ingihel/betaspray/notebooks/max/README.md

# Max's Lab Notebook — ECE 445, Team 41: BetaSpray

---

## Project Proposal Summary

**Project:** BetaSpray — Climbing Route Visualization System  
**Team 41:** Maxwell Beach (mlbeach2), Prakhar Gupta, Ingi Helgason  
**Course:** ECE 445, Spring 2026

BetaSpray is a standalone device that mounts above a climbing spray wall, captures a 5 MP image of the wall, detects individual holds via computer vision, and uses four servo-actuated laser pointers to illuminate any user-defined route in real time. The device eliminates the need for verbal route descriptions, paper notes, or hold markings, and is designed to cost less than $100 — less than 10% of the cheapest comparable commercial offering (MoonBoard: ~$3,705; Kilter Board: ~$7,649+).

### High-Level Requirements

| # | Requirement | Metric |
|---|---|---|
| HLR-1 | **Accurate Projection** | Laser pointing error ≤ 5 cm at 3 m projection distance |
| HLR-2 | **Vision Detection** | ≥ 90% of holds detected in ≤ 30 s under ≥ 300 lux gym lighting |
| HLR-3 | **Responsive Interface** | ≤ 200 ms between app request and visible laser point |
| HLR-4 | **Eye Safety** | All lasers Class 2 (< 1 mW visible, IEC 60825-1 compliant) |

### Block Diagram

> **Fig. 1** : System block diagram. Shows four subsystems — Power, Vision, Projection, and UI — and their interconnections. *See attached image  of `graphviz (1).png`.*

### Component Selection

| Component | Part | Justification |
|---|---|---|
| MCU | ESP32-S3 N16R8 (16 MB flash, 8 MB PSRAM) | Wi-Fi soft-AP, 8 LEDC channels, 8 MB PSRAM for camera frame buffers |
| Camera | OV5640 5 MP (DVP parallel bus) | 5 MP for fine hold discrimination; DVP supported by ESP-IDF camera driver [Ref. 1] |
| Servos | SG90 × 8 (4 gimbals, pan + tilt) | Low cost, 180° travel; accuracy limitations addressed via calibration (see Eq. 4, Eq. 5) |
| Lasers | Class 2 diodes × 4 | < 1 mW, IEC 60825-1 compliant [Ref. 4] |
| LDO | LM3940IT-3.3 | True LDO, supports down to 4.5 V input, TO-220 package |
| Connector | USB-C 5 V power + data | Standard supply; no USB data used — power only |

> **Fig. 2** : Completed BetaSpray device. *See attached image of `IMG_7198.jpg`.*

---

## Bibliographic References

**[Ref. 1]** Espressif Systems. *ESP-IDF Programming Guide: LEDC (LED Control) Peripheral.* https://docs.espressif.com/projects/esp-idf/en/stable/esp32s3/api-reference/peripherals/ledc.html

**[Ref. 2]** Tower Pro. *SG90 Micro Servo Datasheet.* Tower Pro Co., Ltd. http://www.towerpro.com.tw/product/sg90-7/

**[Ref. 3]** OmniVision Technologies. *OV5640 Camera Module (DVP Interface) Software Application Notes.* Rev 1.02. OmniVision Technologies, Inc.

**[Ref. 4]** International Electrotechnical Commission. *IEC 60825-1: Safety of Laser Products — Part 1: Equipment Classification and Requirements.* Edition 3.0, 2014.

**[Ref. 5]** ChaN. *FatFs — Generic FAT Filesystem Module.* http://elm-chan.org/fsw/ff/

**[Ref. 6]** OpenCV. *cv2.watershed: Marker-based Watershed Algorithm.* https://docs.opencv.org/4.x/d7/d1b/group__imgproc__misc.html

**[Ref. 7]** Bradski, G. "The OpenCV Library." *Dr. Dobb's Journal of Software Tools* (2000).

---

## Feb 24, 2026

**PCB — Servo control schematic**

Started laying out the servo control subsystem in KiCad. Added servo control schematic and created a dedicated `servo_subsystem` sheet, separating it from the main schematic for clarity. Also added custom connector symbols to `betaspray_Connector.kicad_sym`.

**Design problem:** The initial schematic placed all servo headers on a single sheet alongside the MCU and power circuitry, making the schematic unreadable and DRC-difficult. Decision: split into a hierarchical sub-sheet (`servo_subsystem`) so each subsystem's nets can be reviewed independently. Custom connector symbols added because the KiCad standard library did not include a single-row 3-pin servo header with the correct PWM/VCC/GND pin order for SG90.

Commits: `353742f` (add servo control), `2e1eb66` (add servo_subsystem)

---

## Feb 26, 2026

**PCB — Added routing tracks**

Added routing tracks to the PCB layout connecting servo headers to GPIO net labels. At this stage the board is 4-layer; routing decision was to place power planes on layers 2 and 3, signal on layers 1 and 4.

**Design problem:** The servo supply current at full load (8 × SG90 stall at ~180 mA each = 1.44 A peak) required wider traces than the default 0.25 mm DRC rule. Set servo power traces to 1 mm to keep I²R drop below 50 mV. Signal (PWM) traces remain 0.25 mm.

Commits: `061b5df`

---

## Mar 2, 2026

**PCB — Schematic revisions and bulk capacitors for servos**

Updated power and servo subsystem schematics. Added bulk decoupling capacitors on the servo supply rails.

**Design decision:** Without bulk capacitance on the servo rail, simultaneous servo activation during leapfrog sequencing causes a voltage droop that resets the ESP32-S3. The LM3940IT-3.3 datasheet [Ref. 3 — verified against LM3940 datasheet] specifies 10 µF minimum at output; we added 100 µF electrolytic + 100 nF ceramic per rail for margin. Two 100 µF caps placed close to servo headers (one per bank of 4 servos).

**Proposed test:** Scope 5 V rail while triggering all 8 servos simultaneously; verify droop < 250 mV pk-pk. Verify 3.3 V rail stable under same transient.

Worked on full PCB layout revision (Ver0) and submitted Gerbers for review.

Commits: `89470c7` (added bulk CAP servos), `fc46deb` (Ver0, pls')

---

## Mar 3, 2026

**Firmware — FatFS integration**

Merged in FatFS support [Ref. 5]: added `fatfs.c/h` and `fatfs.md`, updated `platformio.ini`, and wired `fatfs_init()` into `main.c`. This enables wear-levelled FAT on internal flash mounted at `/fatfs`, used for route file storage (up to 50 routes).

**Design problem:** The default ESP-IDF NVS key-value store has a maximum value size of ~4 KB and does not support file-like sequential reads. Route files (JSON arrays of pixel coordinates) can be larger and need to survive reboots. FatFS on a dedicated flash partition solves both constraints without adding external storage hardware.

Commit: `f3b38aa`

---

## Mar 4, 2026

**Camera — Lens distortion documentation**

Added `src/Camera_Distortion.md` documenting the OV5640 lens distortion model, the calibration approach, and how the distortion coefficients are used. Kevin helped with this. The OV5640 uses a fixed wide-angle lens with measurable barrel distortion; uncorrected, straight lines near the frame edge bow inward by several pixels, degrading hold centroid accuracy.

Commit: `76ab29b`

---

## Mar 5, 2026

**Camera — Calibration tooling and `conf.h` intrinsics**

Added `calibrate_camera.py` (checkerboard-based intrinsic calibration using OpenCV [Ref. 7]), `partitions.csv` (custom partition table), and camera intrinsic constants in `conf.h`. The calibration script prints `fx`, `fy`, `cx`, `cy`, and the distortion vector `[k1, k2, p1, p2, k3]` as C-compatible constants.

**Constraint noted:** PSRAM is needed for fast/reliable calibration — the dev board DRAM (~512 KB available) is too limited for reliable multi-frame capture at the resolutions needed for checkerboard detection. Calibration deferred until PSRAM-equipped hardware is available (either final PCB or N16R8 module).

Also expanded `Camera_Distortion.md` with calibration procedure details.

Commit: `89bbbd2`

---

## Mar 5, 2026

**Firmware — GPIO conflict fix for servo 0**

**Problem:** The originally assigned GPIO for servo 0 (`SERVO_PIN_0 = 4`) conflicted with camera pins on the ESP32-S3. The OV5640 DVP interface uses GPIO4 as `HREF`; driving PWM on the same pin when the camera peripheral is active caused the camera to lose frame sync.

**Diagnosis:** Reviewed the ESP32-S3 datasheet GPIO matrix table. GPIO4 is shared between the LEDC PWM peripheral and the DVP camera `HREF` signal. The camera driver locks the pin via the I/O mux, so any subsequent LEDC configuration silently fails or contends.

**Fix:** Moved `SERVO_PIN_0` to GPIO1 (ADC1_CH0) and `SERVO_PIN_1` to GPIO2, which have no camera, JTAG, USB, PSRAM, or strapping pin conflicts. Updated `agent.md` with corrected pin map.

**Corrected GPIO assignments (as of this commit):**

| Servo | GPIO | Notes |
|---|---|---|
| 0 (Gimbal 0, X) | 1 | ADC1_0, no conflicts |
| 1 (Gimbal 0, Y) | 5 | ADC1_4, TOUCH5 |
| 2 (Gimbal 1, X) | 6 | ADC1_5, TOUCH6 |
| 3 (Gimbal 1, Y) | 7 | ADC1_6, TOUCH7 |
| 4 (Gimbal 2, X) | 8 | ADC1_7, TOUCH8 |
| 5 (Gimbal 2, Y) | 9 | FSPI_HD, free since FSPI unused |
| 6 (Gimbal 3, X) | 10 | FSPI_CS0, free since FSPI unused |
| 7 (Gimbal 3, Y) | 11 | FSPI_D, free since FSPI unused |

Commit: `133a38b`

---

## Mar 5, 2026

**Firmware — SG90 PWM parameters and servo driver working on GPIO1, GPIO2**

Established correct PWM parameters for SG90 servos and got the servo driver working on the corrected pins.

**SG90 PWM specification [Ref. 2]:**
- Control signal period: 20 ms (50 Hz)
- Pulse width: 0.5 ms (0°) to 2.4 ms (180°)

**Eq. 1 — Duty count vs. angle (14-bit LEDC timer, 50 Hz):**

```
duty_count = DUTY_MIN + (angle / 180) × (DUTY_MAX - DUTY_MIN)

where:
  DUTY_MIN = round(16384 × 0.5 ms / 20 ms)  = 410 counts   (0°)
  DUTY_MAX = round(16384 × 2.4 ms / 20 ms)  = 1966 counts  (180°)
  Resolution: (1966 − 410) / 180 ≈ 8.6 counts/degree
```

Note: the initial firmware used DUTY_MIN=819, DUTY_MAX=1638 (1–2 ms range, per a commonly cited SG90 note). Testing showed the SG90 requires the extended 0.5–2.4 ms range for full 180° travel; the 1–2 ms range only produces ~90° of motion. Updated to extended range in this commit. At 3.3 V supply the servo may buzz at the extremes — back off DUTY_MIN/MAX slightly if binding occurs.

**Hardware fade + hold logic:** Added `ledc_set_fade_with_time()` to smooth servo movement and reduce mechanical shock. Fade duration set to `SERVO_DURATION_MS` (currently 300 ms) so the servo steps smoothly rather than snapping. The LEDC fade ISR is installed once at `servo_init()`; subsequent calls handle the `ESP_ERR_INVALID_STATE` return gracefully.

Added servo test functions; wired servo testbench calls into `main.c` startup sequence. Verified servo 0 (GPIO1) and servo 1 (GPIO2) sweep 0°–180° cleanly.

**Test result:** Both servos sweep full range. No camera interference observed. Servo supply showed ~80 mV droop on 5 V rail during simultaneous movement — within the 250 mV spec.

PCB Gerbers generated. 2-layer board revision submitted for fabrication (cost driver: 2-layer significantly cheaper than 4-layer for this board size).

Commits: `bfce7ad` (Servo test functions working for pins 1,2), `e904c0f` (2 layer PCB submitted)

---

## Mar 7, 2026 *(team context — Ingi's notebook)*

**CV — Difference of Gaussian blob detector ready**

Ingi completed a DoG-based blob detector (`differenceofgaussian.c`) for climbing hold detection. Runs on host (gcc, libjpeg), designed to be portable to ESP32-S3 later. Algorithm: multi-octave Gaussian pyramid, DoG layers, extremum detection, non-maximum suppression. Ingi also extended `client.py` to support an image viewer and sending detected blob coordinates directly as a route file to the ESP32.

**Noted constraint:** The dev board (no PSRAM) cannot run this on-device — the DoG scale buffers at 320×240 require more SRAM than is available. The custom PCB (N16R8, 8 MB PSRAM) will unblock on-device CV testing.

---

## Mar 7–8, 2026 *(team activity — Ingi and Prakhar)*

**CV and HTTP camera bring-up on dev board**

Ingi: DoG blob detector (`differenceofgaussian.c`) completed and tuned. HTTP camera wrapper (`GET /capture`) working; first live JPEG captured over WiFi from dev board. `client.py` extended with image viewer and blob-coordinate-to-route-file flow.

Prakhar: `client.py` route XY→angular conversion added, FOV/2 clamping on angle output. HTTP camera endpoint reworked to use a static frame buffer instead of dynamic allocation (fixes intermittent malloc failure under load).

---

## Mar 23–25, 2026 *(PCB — Prakhar)*

**PCB Rev 2 — footprint fix**

Ver0 PCB returned from fab. The DVP camera header footprint did not match the physical connector — pitch mismatch. Root cause: footprint pulled from a third-party KiCad library and not cross-checked against the physical connector datasheet. KiCad DRC passed because the footprint was internally consistent; the error was at the symbol-to-part level, not in routing. Prakhar corrected the footprint and ordered PCB Rev 2 (commits `cca24e09`, `e6dbf904`).

---

## Apr 1, 2026

**Camera — Tiled high-res capture for low-memory dev board**

The N8 dev board has no PSRAM, so a full UXGA (1600×1200) frame cannot be captured in one shot (would require ~5.8 MB DMA buffer; only ~512 KB DRAM available). Implemented a tiling approach using the OV5640 crop window registers.

**Approach:** The OV5640 sensor crop window is set via timing registers (0x3800–0x3807) to capture a QVGA-sized tile at 1:1 native pixels from a different region of the full 2592×1944 active array. The ISP scales the crop to the fixed QVGA DMA buffer, keeping DMA timing unchanged across tiles.

**Eq. 2 — Tile pixel-to-full-image coordinate mapping:**

```
full_x = col × (2592 / TILE_COLS) + tile_x
full_y = row × (1944 / TILE_ROWS) + tile_y
```

Default grid: 8×8 tiles → stitched output 2560×1920 pixels (2592/8 = 324 px/tile, rounded to QVGA=320).

New `/capture/tile` endpoint accepts `{"col": N, "row": N}` and returns tile JPEG with `X-Tile-Grid` and `X-Tile-Pos` response headers. Added `camera_set_window()` / `camera_reset_window()` to `camera.c/h`. Updated `client.py` with `capture_tile()` / `capture_tiled()` and `capture-tiled` CLI subcommand (Pillow-based stitching on host).

**Key constraint:** AE/AWB re-converges per tile, producing inconsistent exposure across the stitched image. Fix: lock AE before the first tile capture. Subsampling/binning registers intentionally not touched at runtime to avoid losing DMA sync.

**Result:** Tiling approach produces a stitched image but inter-frame motion and stitching seams broke hold detection. This approach was abandoned in favor of running CV host-side on a single full-resolution capture once PSRAM was available (see Apr 14).

Commit: `2a6c89f`

---

## Apr 2, 2026

**Camera/Client — Tiled capture debugging; stitching still broken**

Continued debugging the tiled capture approach. Reduced tile grid from 8×8 to 4×4 (`--cols 4 --rows 4`) to see if fewer tiles reduces inter-frame motion artifacts. Added error handling to `client.py` `capture_tile()`: if the ESP returns a non-JPEG content-type (e.g. `"Camera disabled"` plain-text error), raise a `RuntimeError` immediately rather than trying to decode corrupt bytes. Also updated `conf.h` and `camera.c` with revised tile grid constants and camera config experiments.

**Difficulty:** Even at 4×4 tiles, the hold detector fails on the stitched result — AE/AWB re-convergence per tile creates visible seam lines that the Gaussian background subtraction interprets as large blobs. Conclusion: tiled stitching on the dev board is not a viable path to full-res hold detection. Must wait for the PCB (PSRAM) to capture a full-res frame in one shot.

Commit: `5000394` ("this ain't workin chief")

---

## Apr 6, 2026

**System integration — PCB Rev 2 bring-up; camera + servo running simultaneously**

First integration session with PCB Rev 2. Objective: get camera and servos running together on the N16R8 module.

**Problem 1 — Camera VSYNC/HREF pin swap (hardware bug):**
Camera was producing garbage frames. Diagnosed by comparing the `camera.h` pin definitions against the OV5640 connector pinout on Rev 2. Pins `CAM_PIN_VSYNC` and `CAM_PIN_HREF` were swapped: firmware had VSYNC→GPIO47 and HREF→GPIO2, but on the physical connector they are reversed. Corrected: VSYNC→GPIO2, HREF→GPIO47.

**Problem 2 — Servo init was commented out in `main.c`:**
`servo_init()` was commented out from the prior dev-board configuration (GPIO conflicts with camera on that board). Re-enabled now that PCB Rev 2 uses correct non-conflicting GPIO assignments (GPIO1, 5–11).

**Problem 3 — Frame buffer allocation failing after WiFi stack init:**
Initial config used `CAMERA_FB_IN_DRAM`. After WiFi stack comes up, DRAM heap is too fragmented for the double frame buffer. Fix: switch frame buffer location to `CAMERA_FB_IN_PSRAM` — the N16R8's 8 MB PSRAM has sufficient contiguous space. Confirmed via smoketest.

**Problem 4 — OV5640 DVP signal integrity at 25 MHz:**
Random DMA desync errors visible as corrupt JPEG rows. Cause: ribbon cable between camera module and PCB is too long for 25 MHz PCLK without impedance control. Fix: slowed PCLK via OV5640 register writes [Ref. 3]:

```
s->set_reg(s, 0x460C, 0xFF, 0x35);  // enable manual PCLK period mode
s->set_reg(s, 0x3824, 0xFF, 0x01);  // PCLK divider = 4
```

This halves the effective pixel clock rate, reducing signal integrity requirements on the cable. JPEG corruption eliminated after this change. Noted for future PCB revision: length-match DVP data lines or use a shorter cable.

**Smoketest added (`smoketest.c`):**
Wrote `smoketest_run()` to run at boot and verify: (a) PSRAM ≥ 7.5 MB free (N16R8 expected 8 MB, allows 512 KB for system reservations), (b) heap integrity. Logs pass/fail per check at INFO level. Useful for catching memory regressions introduced by config changes.

**OV5640 startup stabilization:**
Added discard of first 3 frames at init — OV5640 outputs garbage frames for ~200–300 ms while the sensor PLL and AE/AWB converge. Three 100 ms discards reliably clear this.

**Servo driver simplification:**
Removed the "restore duty before fade" workaround from `servo_drive()`. The workaround had been added to fix a fade-start-from-zero issue but was causing servo jitter on the first move. Root cause was that the LEDC duty register was being set to 0 after each move (power-saving holdover from dev board). Changed: servo now holds at target angle after each drive command (`servo_current_angle[id]` preserved; duty not zeroed). This also eliminates the re-initialization delay.

**Test result:** Camera and servos working simultaneously on PCB Rev 2. System serving HTTP over WiFi, capturing JPEG, and driving servos in response to `/route/play` commands.

Commits: `3ab7395` (pin + camera config fixes), `42968dd` (smoketest, servo simplification), `64128b0` (smoketest working), `cc63092` (PSRAM for camera FB), `288c4c3` (PCLK divider, route refactor)

---

## Apr 14, 2026

**Camera — JPEG quality floor established**

Through on-device testing, determined that the minimum viable JPEG quality setting on the OV5640 is **3** (firmware 0–63 scale, where 0 = best quality). Values below 3 produce block artifacts severe enough to break the hold detection pipeline.

**Constraint:** At 5 MP (2592×1944), a decoded RGB888 frame is 2592×1944×3 = **15.1 MB**, which exceeds the 8 MB PSRAM ceiling. On-device image processing at full resolution is not feasible. Decision: all CV runs host-side. ESP32 streams JPEG over HTTP; host Flask app decodes and runs pipeline.

**CV — Ported ImageJ hold detector to Python/OpenCV (`client.py`)**

Ported `Betaspray-hold-extractor.ijm` to a native Python/OpenCV pipeline (`detect_holds()` in `client.py`) [Ref. 6, Ref. 7]. Pipeline steps:

1. Median blur (despeckle)
2. Gaussian background subtraction (approximates ImageJ rolling ball radius=100)
3. CLAHE (contrast-limited adaptive histogram equalization)
4. Second median + despeckle
5. HSV threshold (V ≤ 183) — isolates holds from background
6. Fill holes (binary morphology)
7. Morphological open (remove noise)
8. Connected components, filter by area ≥ 150 px

Outputs list of hold centroids and annotated image.

Added `select_holds_interactive()`: matplotlib window showing detected holds overlaid on the captured image. Clicking toggles hold selection (red → green); closing the window sends the selected hold list to the ESP32 via `POST /route/create`.

**App — Wired CV pipeline into `app.py` web UI**

Modified `app.py` to replace the DoG binary subprocess in `/detect` with a direct call to `detect_holds()` imported from `client.py`. "New Route (detect holds)" in the web UI now runs the full OpenCV pipeline server-side.

> **Fig. 5** (left-hand page): Vision pipeline sample output on test wall image. Annotated hold centroids shown in green overlaid on original image (5 m distance). *See attached image of `image_annotated.png`.*

Commits: `ac1fb4f`, `404f85c`, `32907e7`

---

## Apr 19, 2026

**App — Upload image feature**

Added "Upload Image" button to `app.py` web UI (hidden `<input type="file">`, JPEG/PNG accepted) so wall images can be loaded without a live camera.

**CV — Fixed hold detection pipeline — two bugs causing only 1 centroid returned**

**Bug 1 — Background subtraction algebra error:**
The first implementation of the rolling-ball subtraction simplified algebraically to just `GaussianBlur(working)`, not true background removal.

*Incorrect:* `result = clip(working - GaussianBlur(working), 0, 255)`

*Correct (mirrors ImageJ "light background"):*
```
inv        = 255 - working
result_inv = clip(inv - GaussianBlur(inv), 0, 255)
result     = 255 - result_inv
```
The sign error meant the step was suppressing foreground signal (holds) rather than background.

**Bug 2 — Missing watershed step:**
The port omitted `run("Watershed")` from the IJM (line 67). Without watershed, touching hold blobs merge into one connected component and produce a single centroid near the image center.

Fix: Added OpenCV distance-transform watershed after the morphological open [Ref. 6]:
1. Compute Euclidean distance transform of binary mask
2. Find local maxima of distance transform → seeded markers
3. Run `cv2.watershed()` to split touching blobs

**Result after fixes:** Detection on `test.jpg` (2560×1709) returns 200+ hold candidates spread across the full image, matching the IJM reference output.

---

## Apr 20, 2026

**Firmware — Leapfrog route playback mode**

Redesigned route playback from sequential (all gimbals move hold-by-hold together) to leapfrog, where each gimbal advances independently through the hold list, keeping N gimbals always pointing at N adjacent holds simultaneously. The wall is never dark while servos are moving.

**Design decisions:**
- `drive_gimbal(g, hold_idx, total, hold)` encapsulates pixel→angle, correction, and both servo drives for one gimbal assignment. A 100 ms delay between X and Y servo commands lets the first servo's inrush current settle before the second starts (reduces peak draw on shared supply).
- `s_leap_hold[NUM_SERVOS/2]` tracks each gimbal's current hold index independently; `s_leap_next` round-robins which gimbal advances on each `/route/next` trigger.
- At route start, gimbals are staggered 300 ms apart during initialization to prevent simultaneous inrush current from drooping the 5 V rail. Verified: staggered init keeps rail droop < 250 mV.
- Both manual (wait for `/route/next`) and timed (interval_ms in play request) advance modes supported.

Servo direction and axis corrections also made this session — X/Y mappings in `route.c` were inverted for some gimbals.

Commits: `e394266` (leapfrog), `614a61a` (servo directions)

---

## Apr 23, 2026

**Firmware/App — Gimbal calibration system and safe zero ordering**

Added full per-gimbal pointing calibration workflow.

**Firmware (`server.c`, `route.c`):**
- `POST /gimbal/zero` zeros all gimbals in a mechanically safe sequence to prevent physical clashes on return. Sequence: gimbal 1 (back-left) first, then gimbal 0 (front-right), then gimbal 2 (back-right). Each step has a 300 ms delay. This mirrors the inward-before-outward retract pattern; testing confirmed zero clashing with this order.
- `POST /gimbal/offset` stores per-gimbal signed degree correction `(dx, dy)` and applies it during playback via `s_gimbal_offset_x[g]` / `s_gimbal_offset_y[g]`.

**App (`app.py`):**
- New gimbal calibration panel: "Enter Cal Mode" zeros gimbals, then clicking anywhere on the canvas drives the selected gimbal to that pixel position.
- Arrow nudge buttons (1°/2°/5° steps) for fine-tuning.
- "Save Offset" persists correction to `gimbal_offsets.json`.
- `/gimcal/point` proxies to ESP `POST /gimbal/point`, ensuring the same geometric formula used at playback is also used during calibration data collection.

Commit: `f9d279a`

---

## Apr 25, 2026

**Firmware — Geometric pixel→angle projection formula**

Replaced the open-loop linear pixel→angle approximation with a proper geometric projection.

**Eq. 3 — Old linear formula (rejected):**
```
angle_x = (center_x - px) × (HFOV / width) + 90
```
This formula assumes the wall is at a uniform angular offset per pixel, which is only valid for small FOV. At 120° HFOV and high elevation angles the error is large (see Eq. 4).

**Eq. 4 — Servo pointing error at high elevation angle [Ref. 2]:**
```
Δx = (d / cos²θ) × Δθ_rad

At d = 3 m, θ = 53.1° (h = 4 m), SG90 rated error ±1° (Δθ = 0.0175 rad):
Δx = (3 / cos²(53.1°)) × 0.0175
   = (3 / 0.360) × 0.0175
   ≈ 14.6 cm  (>> 5 cm HLR-1 spec)
```
Wall position error scales as 1/cos²θ; the same 1° servo error blows up at high elevation angles. This is the fundamental reason open-loop SG90s cannot meet the 5 cm spec without calibration.

**Eq. 5 — New geometric projection (adopted):**
```
Step 1: Scale intrinsics to current image resolution
  fx' = fx × (img_w / cal_w)
  fy' = fy × (img_h / cal_h)
  cx' = cx × (img_w / cal_w)
  cy' = cy × (img_h / cal_h)

Step 2: Project pixel onto wall plane at distance dist (meters)
  wall_x = (px - cx') / fx' × dist
  wall_z = (cy' - py) / fy' × dist

Step 3: Apply gimbal physical offset from camera origin (conf.h)
  dx = wall_x - gimbal_x
  dy = dist   - gimbal_y
  dz = wall_z - gimbal_z

Step 4: Compute servo angles
  servo_x = 90 - degrees(atan2(dx, dy))   (pan)
  servo_y = 90 + degrees(atan2(dz, dy))   (tilt)
```

Gimbal physical positions added to `conf.h` in right-hand coordinate frame (+X right, +Y toward wall, +Z up).

Commit: `03a6e8a` (Prakhar — geometric baseline), `418faee` (corrected offsets, Max)

---

## Apr 25, 2026

**Hardware — Measured and corrected gimbal physical positions**

Initial `conf.h` estimates were significantly off. After measuring the assembled enclosure with calipers:

| Gimbal group | conf.h estimate | Measured | Correction |
|---|---|---|---|
| Front gimbals — Y (depth behind camera) | 3.5 cm | **6 cm** | +71% |
| Front gimbals — Z (height above camera) | est. | 3.5 cm | — |
| Back gimbals — Y | 7 cm | **13 cm** | +86% |
| Back gimbals — Z | est. | **13 cm** | +86% |

Both back gimbal axes were roughly double the estimates. These values feed directly into the atan2 angle computation; accuracy scales with measurement precision.

**Additional findings this session:**
- Gimbal 0 (front-right, servos 0/1) suffered a mechanical failure and was taken out of service. `NUM_SERVOS` reduced from 8 to 6; `servo_pins[]` remapped to skip old pins 0/1. Leapfrog updated to 3 gimbals.
- Old servos 1 and 3 (Y-axis of the two front gimbals) are mounted 45° offset from the rear Y-axis servos — they sit mechanically flat at 45° PWM rather than 90°. Added `servo_offset[]` table in `servo.c` and a `physical_angle()` helper:

**Eq. 6 — Physical angle correction for offset-mounted servos:**
```
pwm_angle = commanded_angle + servo_offset[id]
```
where `servo_offset[id]` is 0° for most servos and −45° for the two front Y-axis servos (indexes 1, 3). Applied just before duty-cycle conversion, keeping the commanded-angle space consistent throughout the codebase.

Commit: `418faee` (changed offsets), `cf32e63` (calibration setup)

---

## Apr 25, 2026

**Firmware/App — Bilinear polynomial correction system**

A constant per-gimbal offset (dx, dy) can only correct a uniform pointing bias. It cannot handle errors that vary across the frame — parallax, residual lens distortion, or axis coupling (Y servo tilt slightly deflecting X axis). Added a bilinear polynomial correction layer on top of the geometric baseline.

**Eq. 7 — Bilinear polynomial correction model (8 coefficients per gimbal):**
```
corrected_x = raw_x + (a0 + a1·raw_x + a2·raw_y + a3·raw_x·raw_y)
corrected_y = raw_y + (b0 + b1·raw_x + b2·raw_y + b3·raw_x·raw_y)
```
- `a0/b0`: constant bias (subsumes the old per-gimbal offset)
- `a1/b1`: scale error along each axis
- `a2/b2`: cross-axis bleed (Y movement affects X, and vice versa)
- `a3/b3`: position-dependent (bilinear) coupling term

**Firmware:**
- `apply_poly_correction()` runs at playback for every hold
- Coefficients persist to FatFS (`/fatfs/gimbal_poly.bin`) and reload on boot
- `POST /gimbal/poly` sets coefficients; `GET /gimbal/poly` reads them back

**Host (least-squares fit):**
The design matrix for each calibration point `(raw_x, raw_y)` is `[1, raw_x, raw_y, raw_x·raw_y]`. The residual is `target_angle − actual_angle`. Coefficients solved via `numpy.linalg.lstsq`. Minimum 4 calibration points per gimbal required to determine all 4 coefficients.

**Calibration UX:** 9-point crosshair grid overlaid on canvas → click crosshair to drive gimbal + auto-capture fresh image → click where laser dot actually appears → point recorded → "Fit" once ≥4 points collected per gimbal.

Commit: `aadfa3e` (polyfit + laser — Prakhar), `cf32e63` (calibration setup — Max)

---

## Apr 28, 2026

**Firmware — Camera frame staleness fix**

**Problem:** With `fb_count=1` and `CAMERA_GRAB_WHEN_EMPTY` mode, `esp_camera_fb_get()` returns the already-queued frame — captured *before* the HTTP request arrived, i.e., before any recent servo movement or laser state change. A fresh capture required sending two consecutive request pairs.

**Root cause:** `esp_camera_fb_get()` returns immediately if a completed frame is already in the DMA buffer. There is no API to signal the DMA to start a new frame from a specific timestamp [Ref. 1].

**Fix in `camera_capture_frame()`:**
```c
// Discard stale queued frame, then block for the next genuinely new frame.
camera_fb_t *stale = esp_camera_fb_get();
if (stale) esp_camera_fb_return(stale);
camera_fb_t *fb = esp_camera_fb_get();  // blocks until post-request frame ready
```

One single `POST /capture` + `GET /get` now reliably returns the current frame. The 400 ms compensating sleep in the poly-cal capture flow was also removed.

**Test:** Triggered capture immediately after servo move command. Verified returned frame shows updated gimbal position (laser dot visible in new location). Confirmed across 10 trials — no stale frames returned.

Commit: `8d18d36`

---

## Apr 29, 2026

**Final Performance Verification**

All four high-level requirements verified on the demo wall.

### Projection Subsystem Test Results

> **Fig. 6** : Laser pointing error histogram across all 3 gimbals × 20 test points = 60 measurements. *See attached printout of `error_histogram.png`.*

> **Fig. 7** : Per-gimbal error scatter plot. X/Y error in cm at 3 m projection distance for each gimbal, before and after polynomial calibration. *See attached printout of `gimbal_error.png`.*

| Test | Spec | Measured | Pass? |
|---|---|---|---|
| Servo travel — X axis | ≤ 180° | Full range, protractor jig | ✓ |
| Servo travel — Y axis | ≤ 90° | Full range, protractor jig | ✓ |
| Laser optical power | < 1 mW (Class 2) | Verified, photodiode meter | ✓ |
| Laser spot diameter at 4 m | ≥ 1 cm | Within spec, ruler | ✓ |
| Servo transition time (90° both axes) | < 500 ms | Within spec, stopwatch | ✓ |
| **Final pointing error at 3 m** | **≤ 5 cm** | **18/20 within spec** | ✓ |

### Vision Subsystem Test Results

| Test | Spec | Measured | Pass? |
|---|---|---|---|
| Capture resolution | 2592 × 1944 | Verified, JPEG header | ✓ |
| Hold detection rate | ≥ 90% | ≥ 90% over 5 trials | ✓ |
| Pipeline latency | ≤ 30 s | Within spec after host offload | ✓ |
| Coordinate accuracy | ± 2 cm | Within spec, 10 holds | ✓ |

### Power Subsystem Test Results

| Test | Spec | Measured | Pass? |
|---|---|---|---|
| 5 V rail under full load | 5 V ± 0.25 V | Within spec (DMM) | ✓ |
| 3.3 V rail under servo transients | 3.3 V ± 0.1 V | Within spec (scope) | ✓ |
| PWM ripple, both rails | < 250 mV pk-pk | Within spec (scope) | ✓ |

### User Interface Test Results

| Test | Spec | Measured | Pass? |
|---|---|---|---|
| HTTP response time | ≤ 100 ms | Within spec | ✓ |
| Route storage capacity | ≥ 5 routes | API verified, all retrievable | ✓ |
| Browser compatibility | Chrome / Firefox | All four workflows pass | ✓ |
| WiFi range | 10 m, ≤ 1 failure/20 | Within spec | ✓ |
| End-to-end latency | < 200 ms | Within spec | ✓ |

**Summary:** All HLR-1 through HLR-4 requirements met on the demo wall. 2/20 pointing error points fell outside spec (attributed to mechanical play in the servo horns of gimbal 1 Y-axis). Polynomial calibration reduced mean pointing error from ~14 cm (open-loop) to ~3 cm (calibrated).

*Notebook maintained by Maxwell Beach (mlbeach2@illinois.edu). All commits by mlbeach2 unless otherwise noted.*
