ingihel/betaspray/notebooks/meetings.md

### Date : 2-24-2026  
- Schematic in progress. ESP32-based.  
- Discussed overall idea- blocks on wall - CV.  
- Machine shop conversation. Greg asked for board size, mounting holes and light sources. 
- To do : Submit PCB in first round - ESP32 + peripherals + USBC receptacle + stencil
