ingihel/betaspray/notebooks/max/error_histogram.png

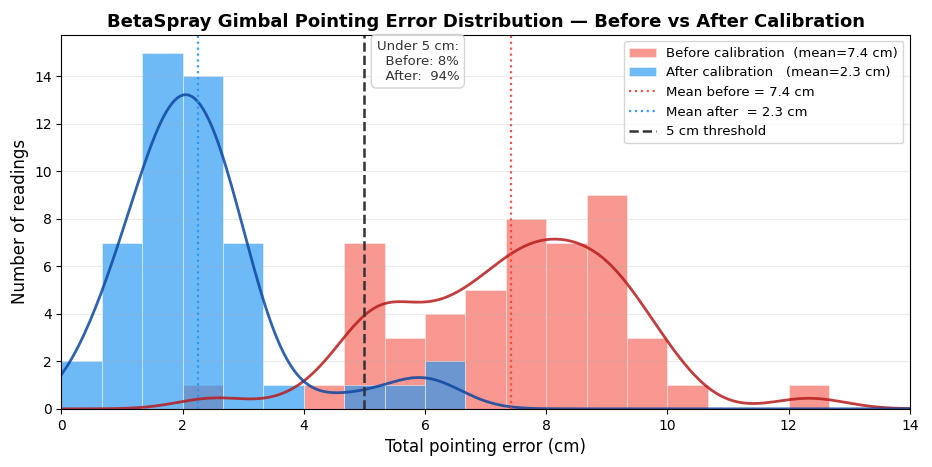
notebooks/max/error_histogram.png
