ingihel/betaspray/notebooks/max/gimbal_error.png

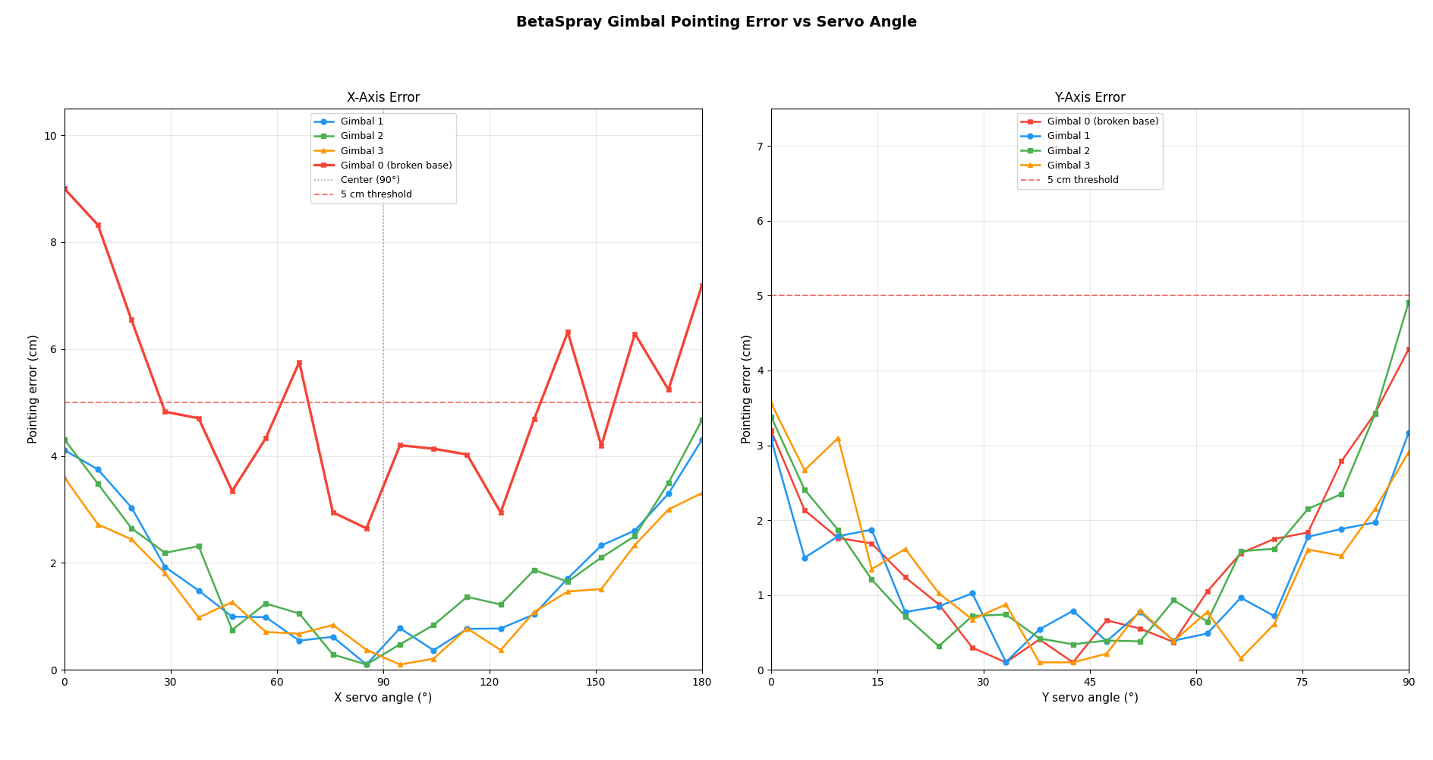
notebooks/max/gimbal_error.png
