ingihel/betaspray/notebooks/max/graphviz (1).png

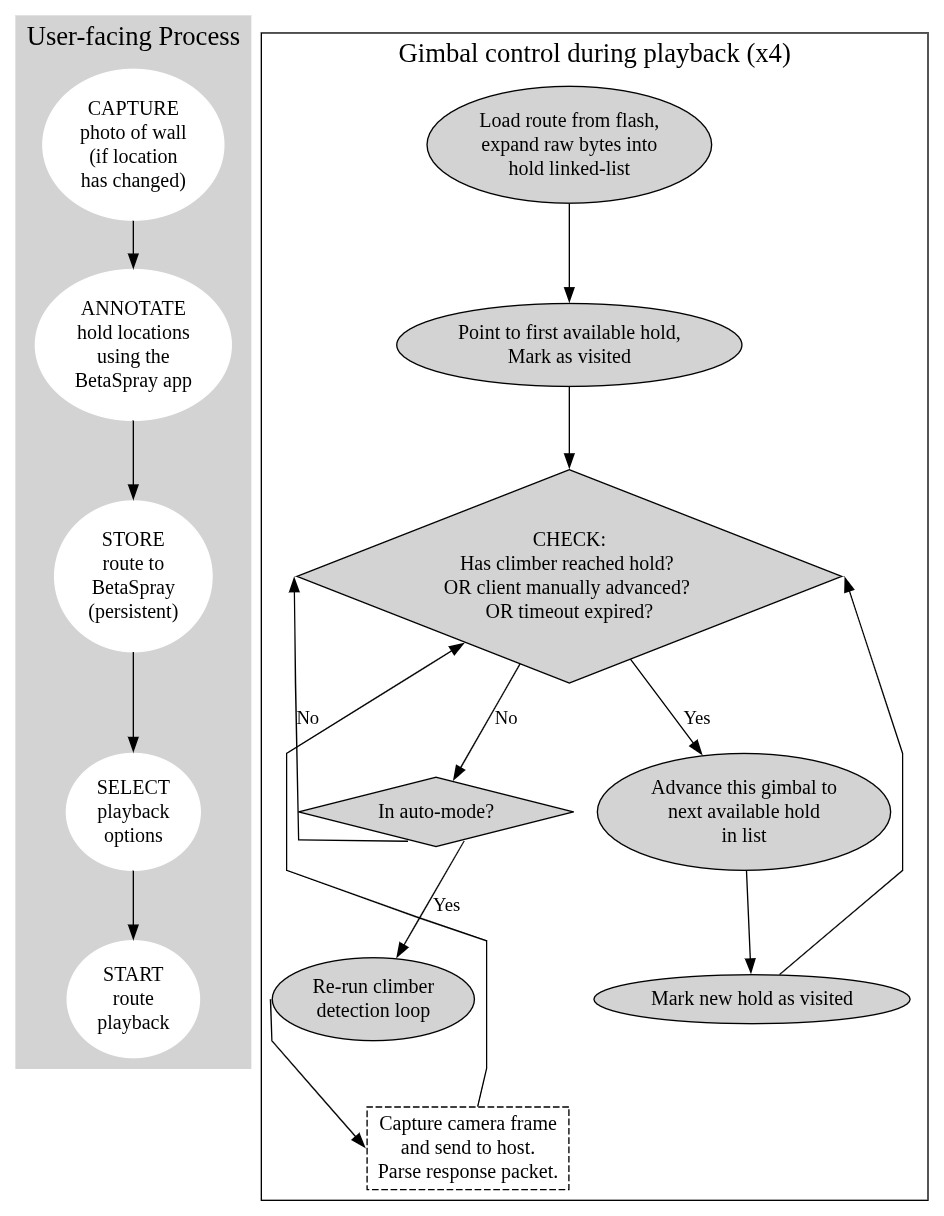
notebooks/max/graphviz (1).png
