ingihel/betaspray/notebooks/max/image_annotated.png

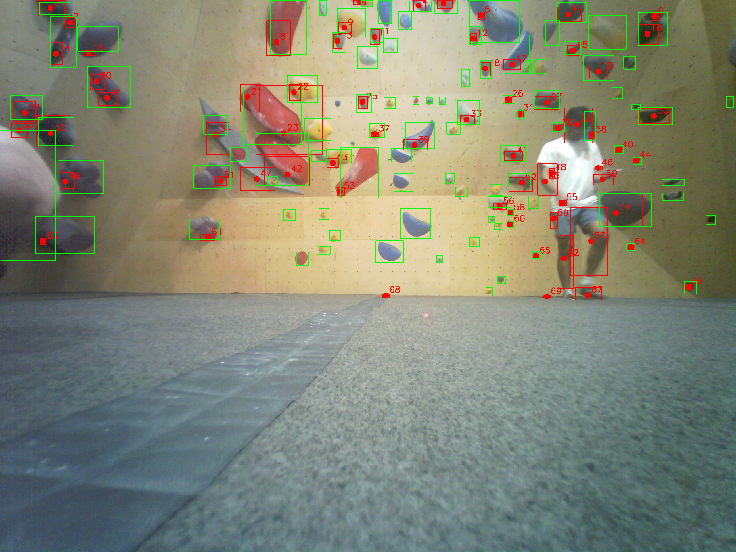
notebooks/max/image_annotated.png
