ingihel/betaspray/notebooks/max/IMG_7198.jpg

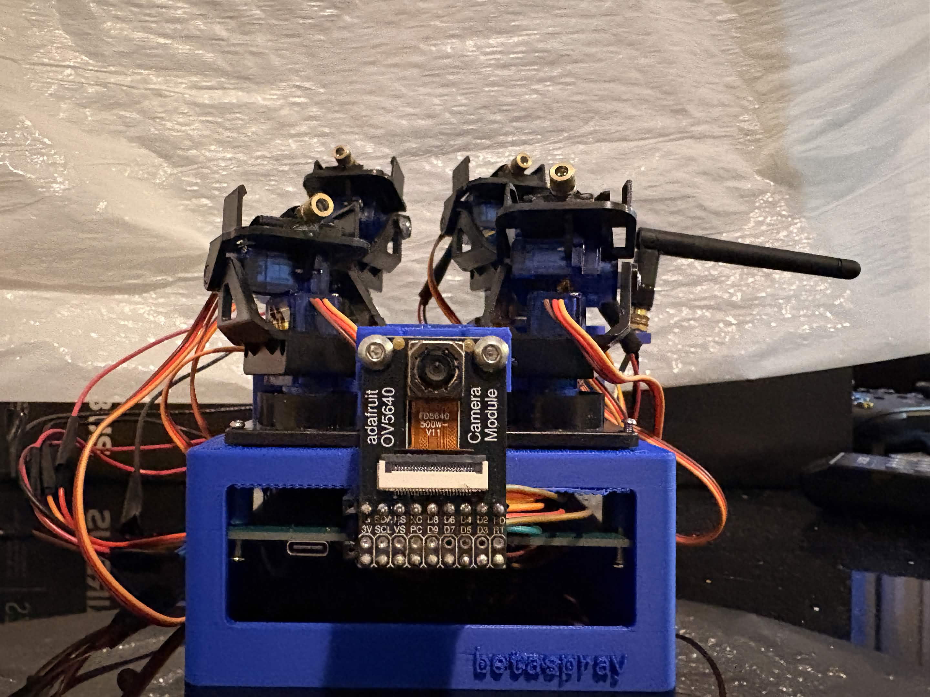
notebooks/max/IMG_7198.jpg
