ingihel/betaspray/betaspray-pcb/betaspray-pcb.kicad_pcb

## KiCad design betaspray-pcb/betaspray-pcb.kicad_pcb (2026-03-24)

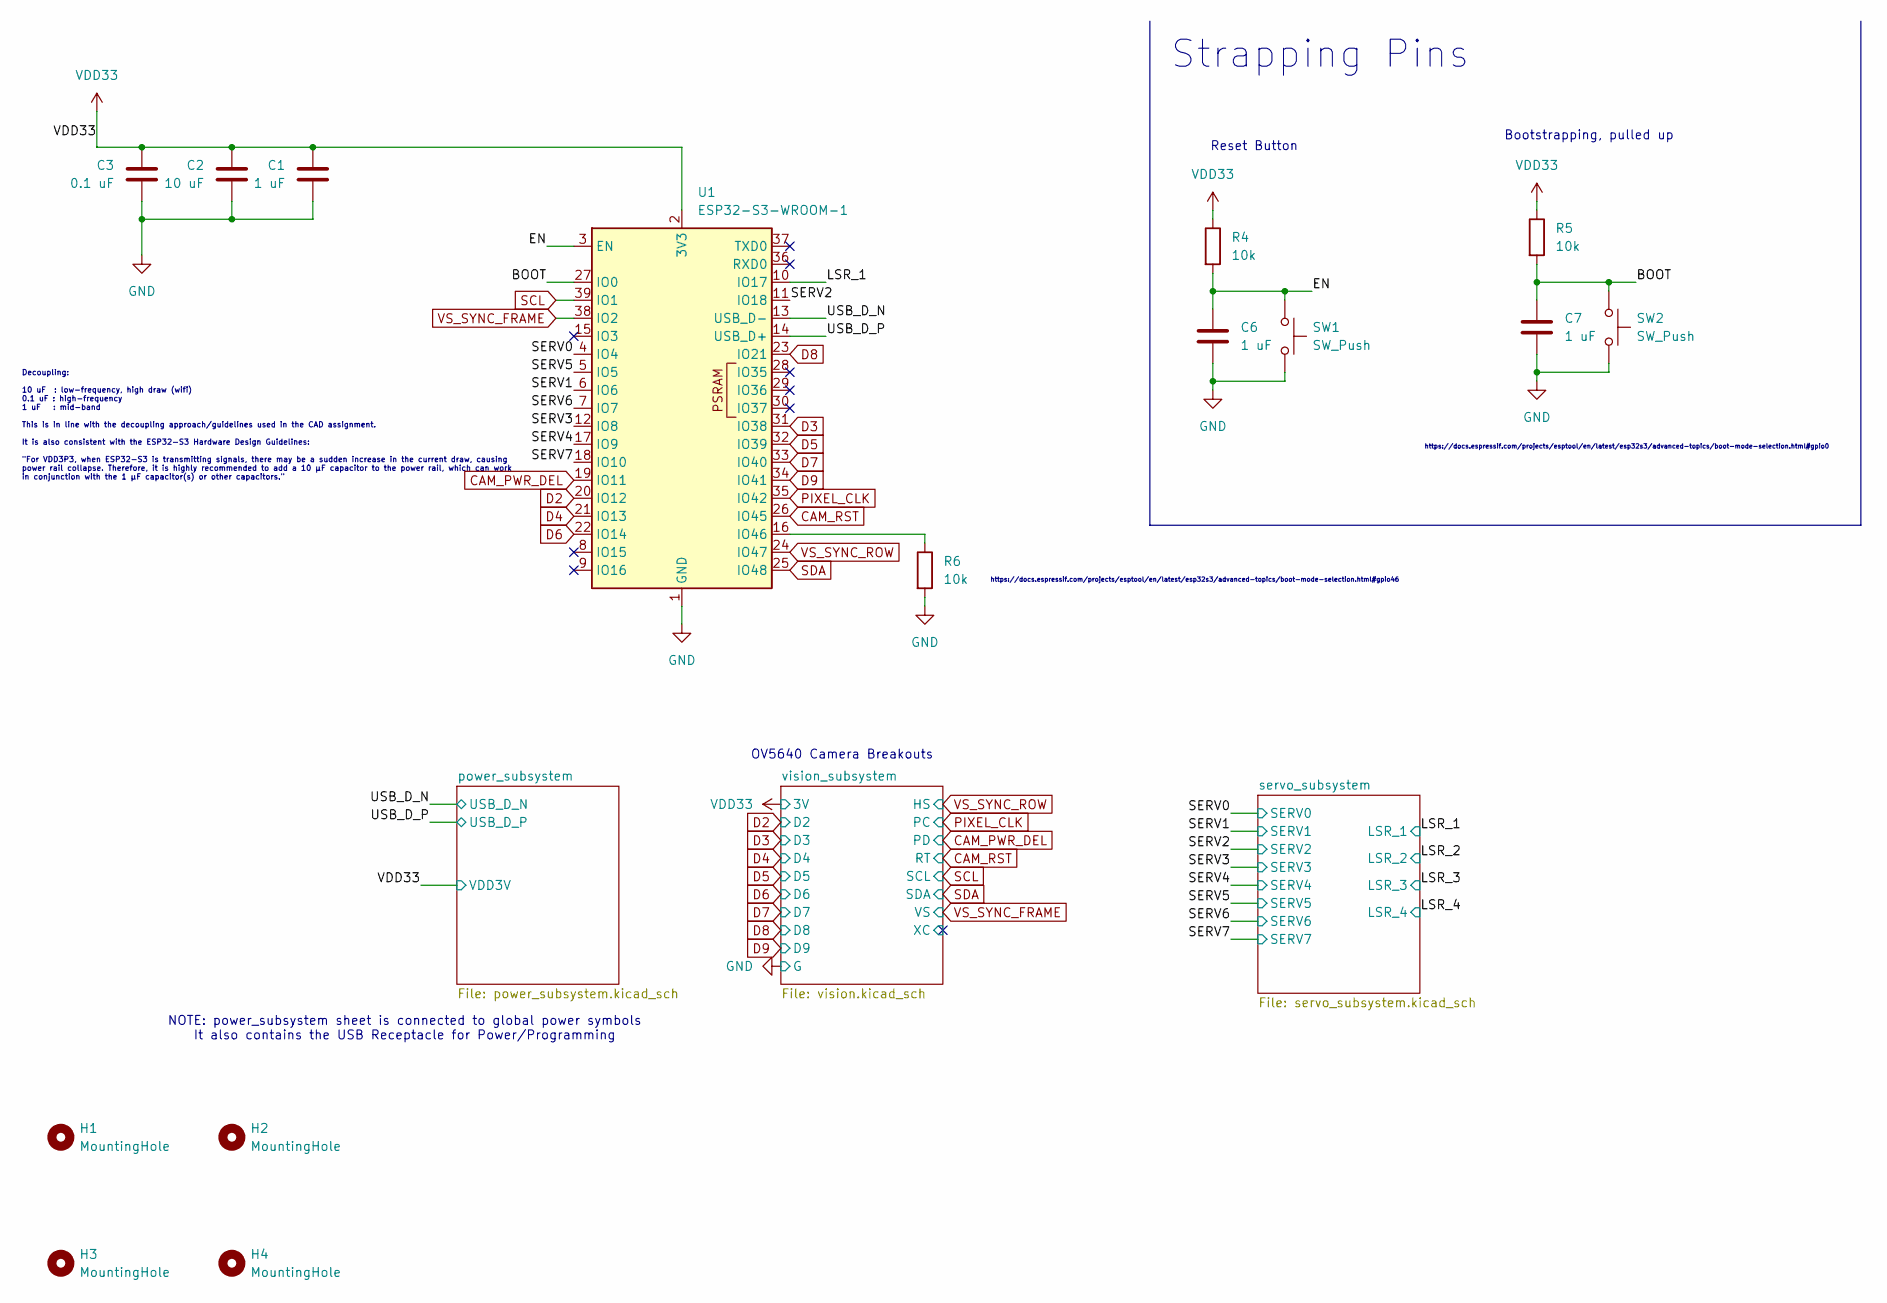
[picture p9: schematic betaspray-pcb.kicad_sch]

Parts:
C1, C6, C7: 1 uF; C_0805_2012Metric_Pad1.18x1.45mm_HandSolder
C2: 10 uF; C_0805_2012Metric_Pad1.18x1.45mm_HandSolder
C3: 0.1 uF; C_0805_2012Metric_Pad1.18x1.45mm_HandSolder
H1, H2, H3, H4: MountingHole; MountingHole_3.2mm_M3
R4, R5, R6: 10k; R_0805_2012Metric_Pad1.20x1.40mm_HandSolder
SW1, SW2: SW_Push; SW_DIP_SPSTx02_Slide_9.78x7.26mm_W8.61mm_P2.54mm
U1: ESP32-S3-WROOM-1; ESP32-S3-WROOM-1U

Connections:
/BOOT: C7.1, R5.2, SW2.1, U1.27 (IO0)
/EN: C6.1, R4.2, SW1.1, U1.3 (EN)
/LSR_1: U1.10 (IO17); also elsewhere on the board
/SERV0: U1.4 (IO4); also elsewhere on the board
/SERV1: U1.6 (IO6); also elsewhere on the board
/SERV2: U1.11 (IO18); also elsewhere on the board
/SERV3: U1.12 (IO8); also elsewhere on the board
/SERV4: U1.17 (IO9); also elsewhere on the board
/SERV5: U1.5 (IO5); also elsewhere on the board
/SERV6: U1.7 (IO7); also elsewhere on the board
/SERV7: U1.18 (IO10); also elsewhere on the board
/USB_D_N: U1.13 (USB_D-); also elsewhere on the board
/USB_D_P: U1.14 (USB_D+); also elsewhere on the board
CAM_PWR_DEL: U1.19 (IO11); also elsewhere on the board
CAM_RST: U1.26 (IO45); also elsewhere on the board
D2: U1.20 (IO12); also elsewhere on the board
D3: U1.31 (IO38); also elsewhere on the board
D4: U1.21 (IO13); also elsewhere on the board
D5: U1.32 (IO39); also elsewhere on the board
D6: U1.22 (IO14); also elsewhere on the board
D7: U1.33 (IO40); also elsewhere on the board
D8: U1.23 (IO21); also elsewhere on the board
D9: U1.34 (IO41); also elsewhere on the board
GND: C1.2, C2.2, C3.2, C6.2, C7.2, R6.2, SW1.2, SW2.2, U1.1 (GND), U1.40 (GND), U1.41 (GND); also elsewhere on the board
unnamed: R6.1, U1.16 (IO46)
PIXEL_CLK: U1.35 (IO42); also elsewhere on the board
SCL: U1.39 (IO1); also elsewhere on the board
SDA: U1.25 (IO48); also elsewhere on the board
VDD33: C1.1, C2.1, C3.1, R4.1, R5.1, U1.2 (3V3); also elsewhere on the board
VS_SYNC_FRAME: U1.38 (IO2); also elsewhere on the board
VS_SYNC_ROW: U1.24 (IO47); also elsewhere on the board

Notes on the sheet:
https://docs.espressif.com/projects/esptool/en/latest/esp32s3/advanced-topics/boot-mode-selection.html#gpio0
Reset Button
Decoupling: 10 uF : low-frequency, high draw (wifi) 0.1 uF : high-frequency 1 uF : mid-band This is in line with the decoupling approach/guidelines used in the CAD assignment. It is also consistent with the ESP32-S3 Hardware Design Guidelines: "For VDD3P3, when ESP32-S3 is transmitting signals, the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
Strapping Pins
Bootstrapping, pulled up
OV5640 Camera Breakouts
NOTE: power_subsystem sheet is connected to global power symbols It also contains the USB Receptacle for Power/Programming
https://docs.espressif.com/projects/esptool/en/latest/esp32s3/advanced-topics/boot-mode-selection.html#gpio46

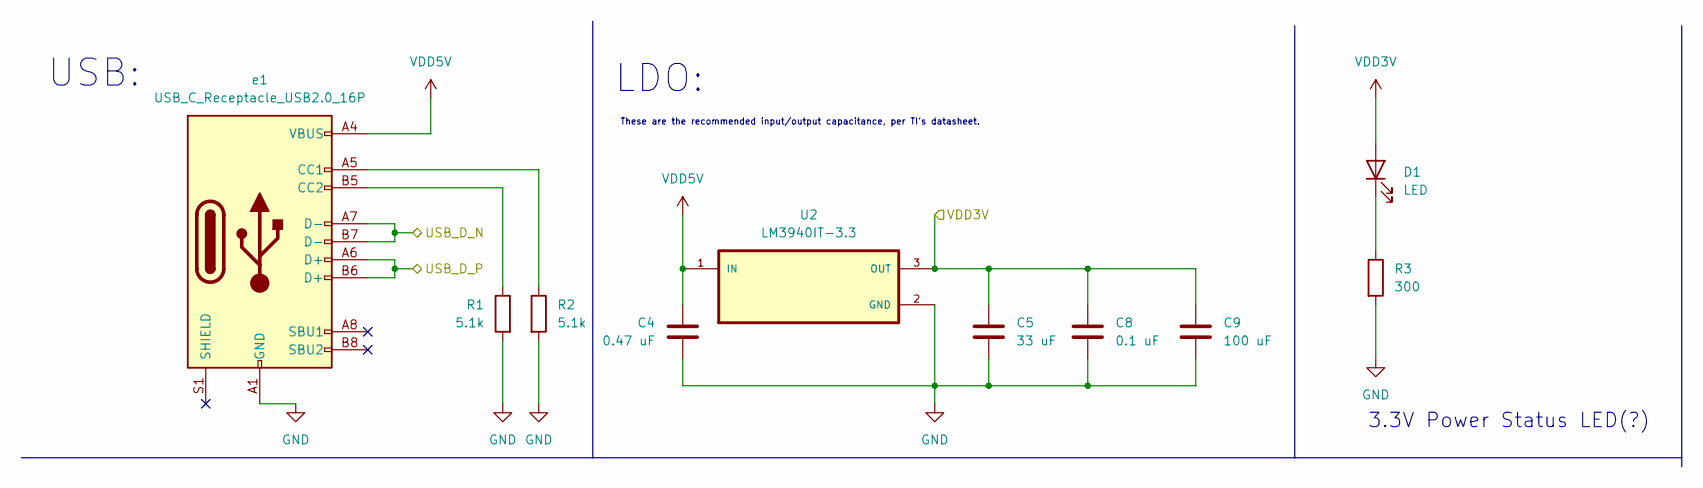
[picture p10: schematic power_subsystem.kicad_sch]

Parts:
C4: 0.47 uF; C_0805_2012Metric_Pad1.18x1.45mm_HandSolder
C5: 33 uF; C_0805_2012Metric_Pad1.18x1.45mm_HandSolder
C8: 0.1 uF; C_0805_2012Metric_Pad1.18x1.45mm_HandSolder
C9: 100 uF; C_0805_2012Metric_Pad1.18x1.45mm_HandSolder
D1: LED; LED_0805_2012Metric
R1, R2: 5.1k; R_0805_2012Metric_Pad1.20x1.40mm_HandSolder
R3: 300; R_0805_2012Metric_Pad1.20x1.40mm_HandSolder
U2: LM3940IT-3.3; TO254P1054X470X1955-3
e1: USB_C_Receptacle_USB2.0_16P; USB_C_Receptacle_G-Switch_GT-USB-7010ASV

Connections:
/USB_D_N: e1.A7 (D-), e1.B7 (D-); also elsewhere on the board
/USB_D_P: e1.A6 (D+), e1.B6 (D+); also elsewhere on the board
GND: C4.2, C5.2, C8.2, C9.2, R1.2, R2.2, R3.2, U2.2 (GND), e1.A1 (GND), e1.A12 (GND), e1.B1 (GND), e1.B12 (GND); also elsewhere on the board
unnamed: D1.1 (K), R3.1
unnamed: R2.1, e1.A5 (CC1)
unnamed: R1.1, e1.B5 (CC2)
VDD5V: C4.1, U2.1 (IN), e1.A4 (VBUS), e1.A9 (VBUS), e1.B4 (VBUS), e1.B9 (VBUS); also elsewhere on the board
VDD33: C5.1, C8.1, C9.1, D1.2 (A), U2.3 (OUT); also elsewhere on the board

Notes on the sheet:
USB:
These are the recommended input/output capacitance, per TI's datasheet.
LDO:
3.3V Power Status LED(?)

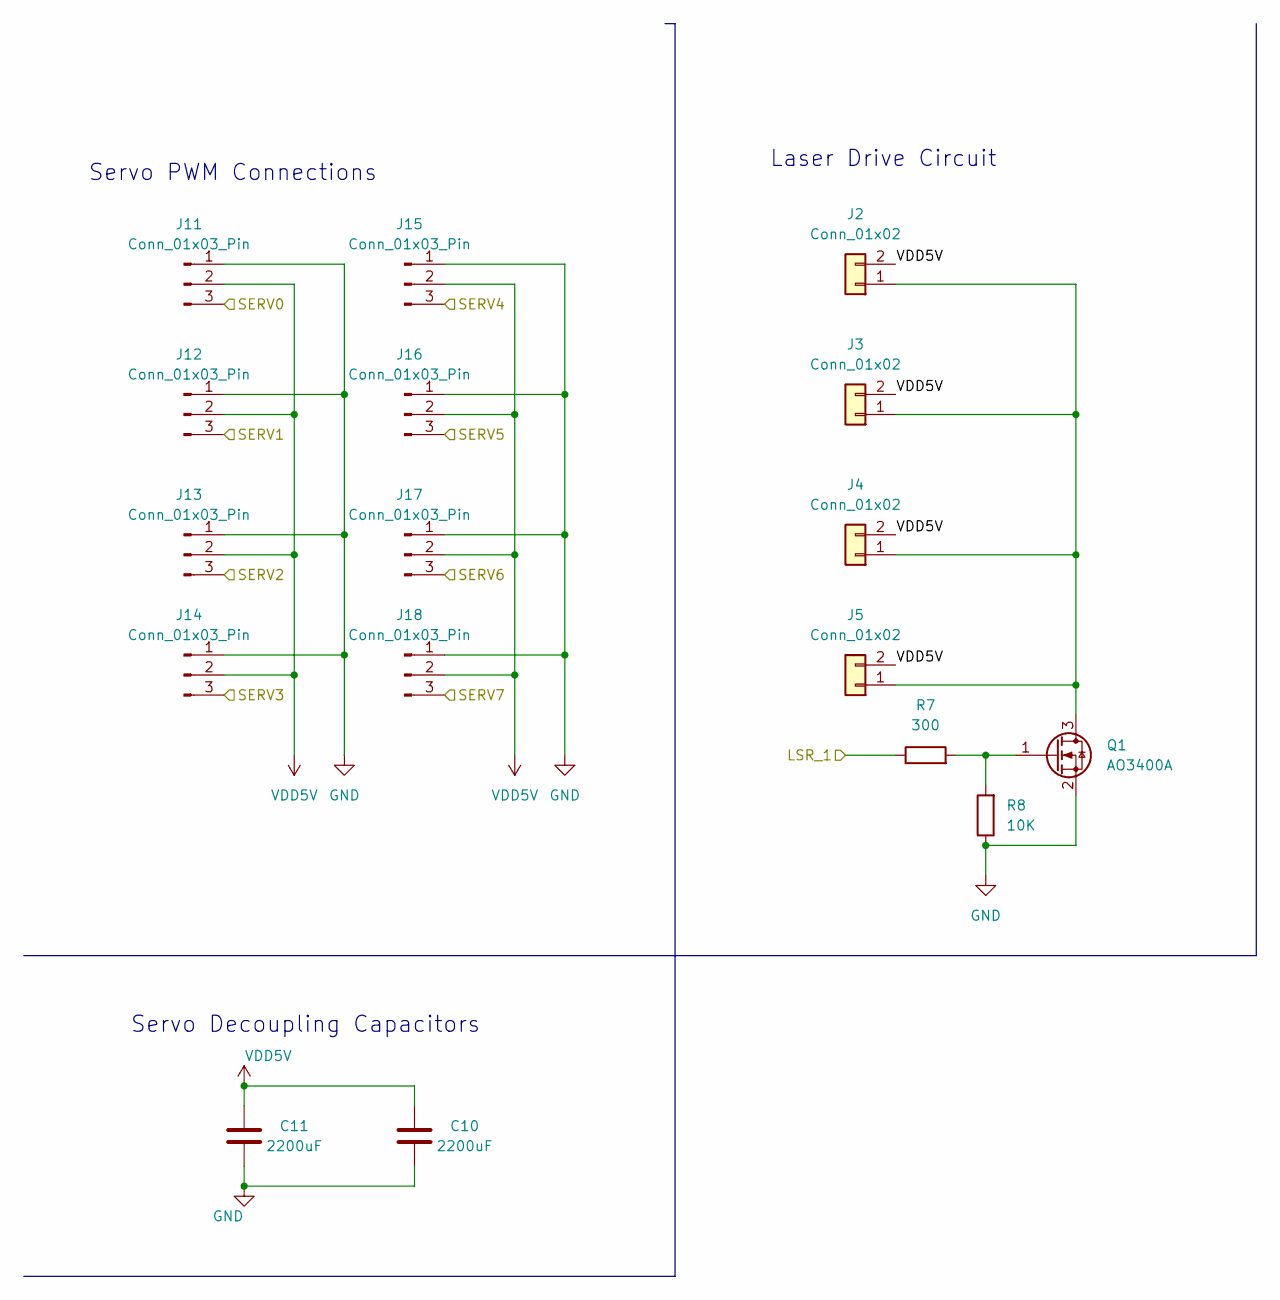
[picture p11: schematic servo_subsystem.kicad_sch]

Parts:
C10, C11: 2200uF; CP_Radial_D16.0mm_P7.50mm
J2, J3, J4, J5: Conn_01x02; PinHeader_2x01_P2.54mm_Vertical
J11, J12, J13, J14, J15, J16, J17, J18: Conn_01x03_Pin; FanPinHeader_1x03_P2.54mm_Vertical
Q1: AO3400A; SOT-23
R7: 300; R_0805_2012Metric_Pad1.20x1.40mm_HandSolder
R8: 10K; R_0805_2012Metric_Pad1.20x1.40mm_HandSolder

Connections:
/LSR_1: R7.1; also elsewhere on the board
/SERV0: J11.3; also elsewhere on the board
/SERV1: J12.3; also elsewhere on the board
/SERV2: J13.3; also elsewhere on the board
/SERV3: J14.3; also elsewhere on the board
/SERV4: J15.3; also elsewhere on the board
/SERV5: J16.3; also elsewhere on the board
/SERV6: J17.3; also elsewhere on the board
/SERV7: J18.3; also elsewhere on the board
GND: C10.2, C11.2, J11.1, J12.1, J13.1, J14.1, J15.1, J16.1, J17.1, J18.1, Q1.2 (S), R8.1; also elsewhere on the board
unnamed: J2.1, J3.1, J4.1, J5.1, Q1.3 (D)
unnamed: Q1.1 (G), R7.2, R8.2
VDD5V: C10.1, C11.1, J2.2, J3.2, J4.2, J5.2, J11.2, J12.2, J13.2, J14.2, J15.2, J16.2, J17.2, J18.2; also elsewhere on the board

Notes on the sheet:
Laser Drive Circuit
Servo PWM Connections
Servo Decoupling Capacitors

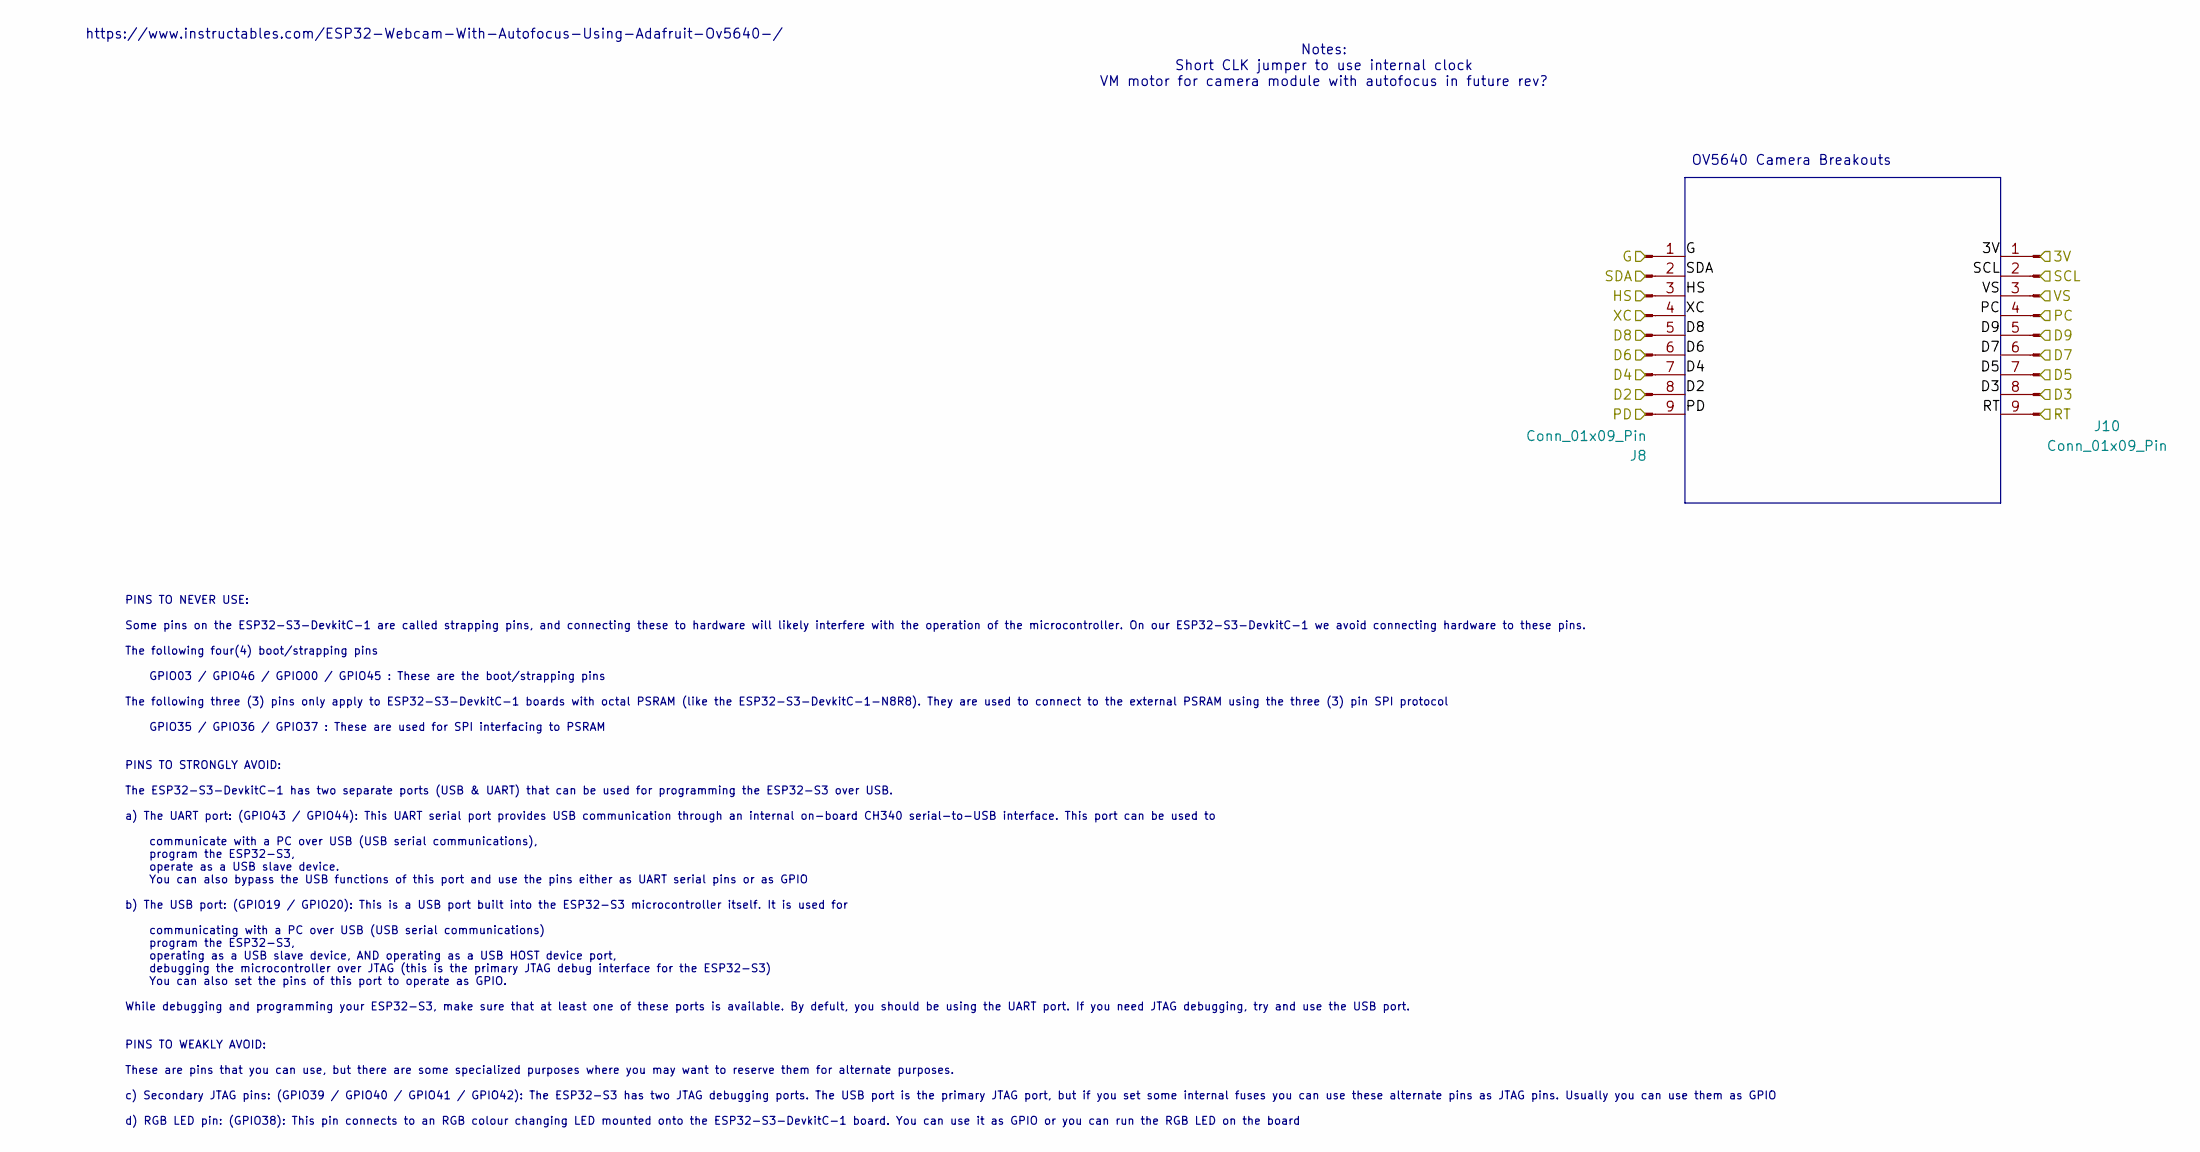
[picture p12: schematic vision.kicad_sch]

Parts:
J8, J10: Conn_01x09_Pin; PinHeader_1x09_P2.54mm_Vertical

Connections:
/vision_subsystem/XC: J8.4
CAM_PWR_DEL: J8.9; also elsewhere on the board
CAM_RST: J10.9; also elsewhere on the board
D2: J8.8; also elsewhere on the board
D3: J10.8; also elsewhere on the board
D4: J8.7; also elsewhere on the board
D5: J10.7; also elsewhere on the board
D6: J8.6; also elsewhere on the board
D7: J10.6; also elsewhere on the board
D8: J8.5; also elsewhere on the board
D9: J10.5; also elsewhere on the board
GND: J8.1; also elsewhere on the board
PIXEL_CLK: J10.4; also elsewhere on the board
SCL: J10.2; also elsewhere on the board
SDA: J8.2; also elsewhere on the board
VDD33: J10.1; also elsewhere on the board
VS_SYNC_FRAME: J10.3; also elsewhere on the board
VS_SYNC_ROW: J8.3; also elsewhere on the board

Notes on the sheet:
Notes: Short CLK jumper to use internal clock VM motor for camera module with autofocus in future rev?
PINS TO NEVER USE: Some pins on the ESP32-S3-DevkitC-1 are called strapping pins, and connecting these to hardware will likely interfere with the operation of the microcontroller. On our ESP32-S3-DevkitC-1 we avoid connecting hardware to these pins. The following four(4) boot/strapping pins GPIO03 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
OV5640 Camera Breakouts
https://www.instructables.com/ESP32-Webcam-With-Autofocus-Using-Adafruit-Ov5640-/

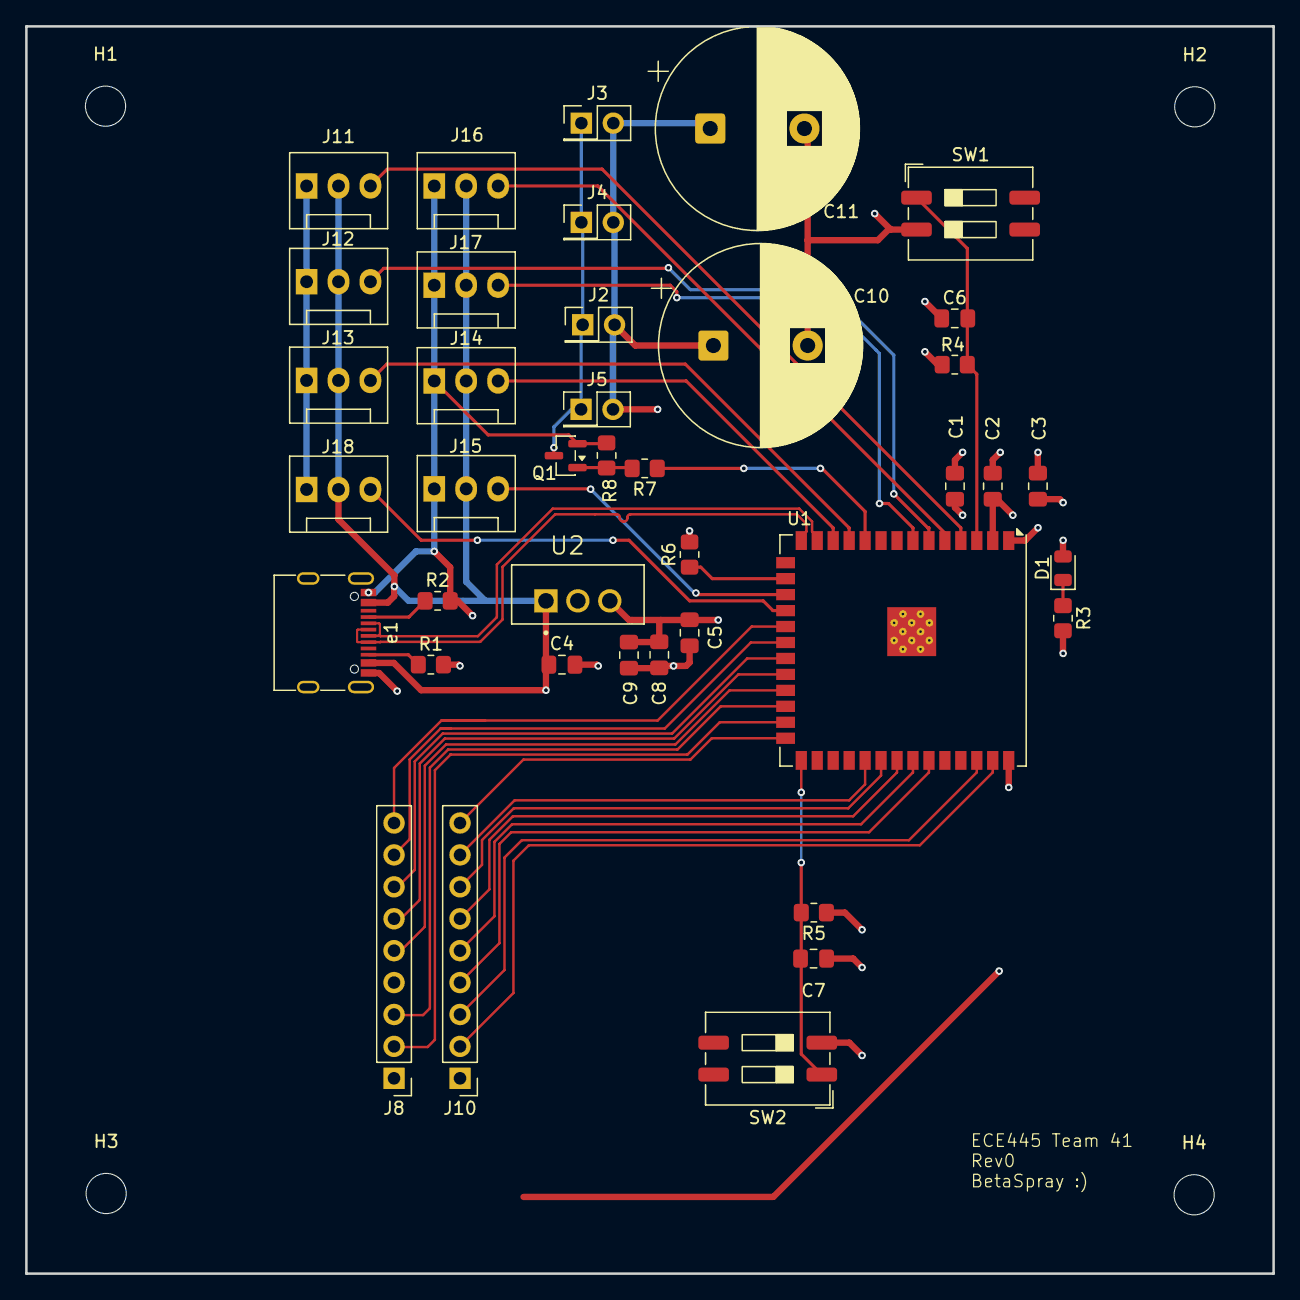
[picture p13: board betaspray-pcb.kicad_pcb from above]

Board: 4 copper layers, 99.3 x 99.3 mm, 44 parts (0 on the bottom side), 37 nets.
