ingihel/betaspray/(commit log)

2026-02-24 Init? I think?
    [betaspray-pcb.kicad_pcb, betaspray-pcb.kicad_sch]
2026-02-24 Add LDO
    [betaspray-pcb.kicad_sch]
2026-02-24 add servo control
    [betaspray-pcb.kicad_sch]
2026-02-24 Vision subsystem sheet
    [betaspray-pcb.kicad_sch, vision.kicad_sch]
2026-02-24 Added images and notes for wiring recommendations for vision subsys
    [vision.kicad_sch]
2026-02-24 Add power sheet, fix MCU footprint?
    [betaspray-pcb.kicad_sch, power_subsystem.kicad_sch, vision.kicad_sch]
2026-02-24 add servo_subsystem
    [betaspray-pcb.kicad_sch, power_subsystem.kicad_sch, servo_subsystem.kicad_sch, vision.kicad_sch]
2026-02-24 Add USB-C, connection, power decoupling
    [betaspray-pcb.kicad_sch, power_subsystem.kicad_sch, servo_subsystem.kicad_sch, vision.kicad_sch]
2026-02-25 status led ???
    [power_subsystem.kicad_sch]
2026-02-25 pinout assignment for cam
    [betaspray-pcb.kicad_sch]
2026-02-26 Add strapping pins
    This should be correct, afaict
    Still considering the automatic boot selection
    via `esptool` described in:
    https://docs.espressif.com/projects/esptool/en/latest/esp32s3/advanced-topics/boot-mode-selection.html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
    :)
    [betaspray-pcb.kicad_sch]
2026-02-26 fix servo pins
    [betaspray-pcb.kicad_sch, power_subsystem.kicad_sch, servo_subsystem.kicad_sch, vision.kicad_sch]
2026-02-26 Connected Servo labels, added debug led
    [betaspray-pcb.kicad_sch, power_subsystem.kicad_sch, servo_subsystem.kicad_sch, vision.kicad_sch]
2026-02-26 Started layout
    [betaspray-pcb.kicad_pcb, betaspray-pcb.kicad_sch, power_subsystem.kicad_sch, servo_subsystem.kicad_sch, vision.kicad_sch]
2026-02-26 99.4mmx99.4mm layout
    [betaspray-pcb.kicad_pcb]
2026-02-26 Trying to route
    [betaspray-pcb.kicad_pcb, betaspray-pcb.kicad_sch, power_subsystem.kicad_sch]
2026-03-01 Stiched the planes
    [betaspray-pcb.kicad_pcb]
2026-03-01 Added lasers to schematic and footprint
    [betaspray-pcb.kicad_pcb, betaspray-pcb.kicad_sch, servo_subsystem.kicad_sch]
2026-03-03 Change Laser diode layout
    [betaspray-pcb.kicad_sch, power_subsystem.kicad_sch, servo_subsystem.kicad_sch, vision.kicad_sch]
2026-03-03 Add more decoupling caps?
    [betaspray-pcb.kicad_sch, power_subsystem.kicad_sch]
2026-03-03 added bulk CAP servos
    [betaspray-pcb.kicad_sch, power_subsystem.kicad_sch, servo_subsystem.kicad_sch]
2026-03-03 Ver0, pls'
    [betaspray-pcb.kicad_pcb, betaspray-pcb.kicad_sch, power_subsystem.kicad_sch, servo_subsystem.kicad_sch]
2026-03-05 Tweak pcb slightly
    [betaspray-pcb.kicad_pcb, betaspray-pcb.kicad_sch, power_subsystem.kicad_sch, servo_subsystem.kicad_sch, vision.kicad_sch]
2026-03-24 fixed footprint
    [betaspray-pcb.kicad_pcb, vision.kicad_sch]
